KarthikeyanGatla/VibeGuard/docs/images/wiring_real_board.png

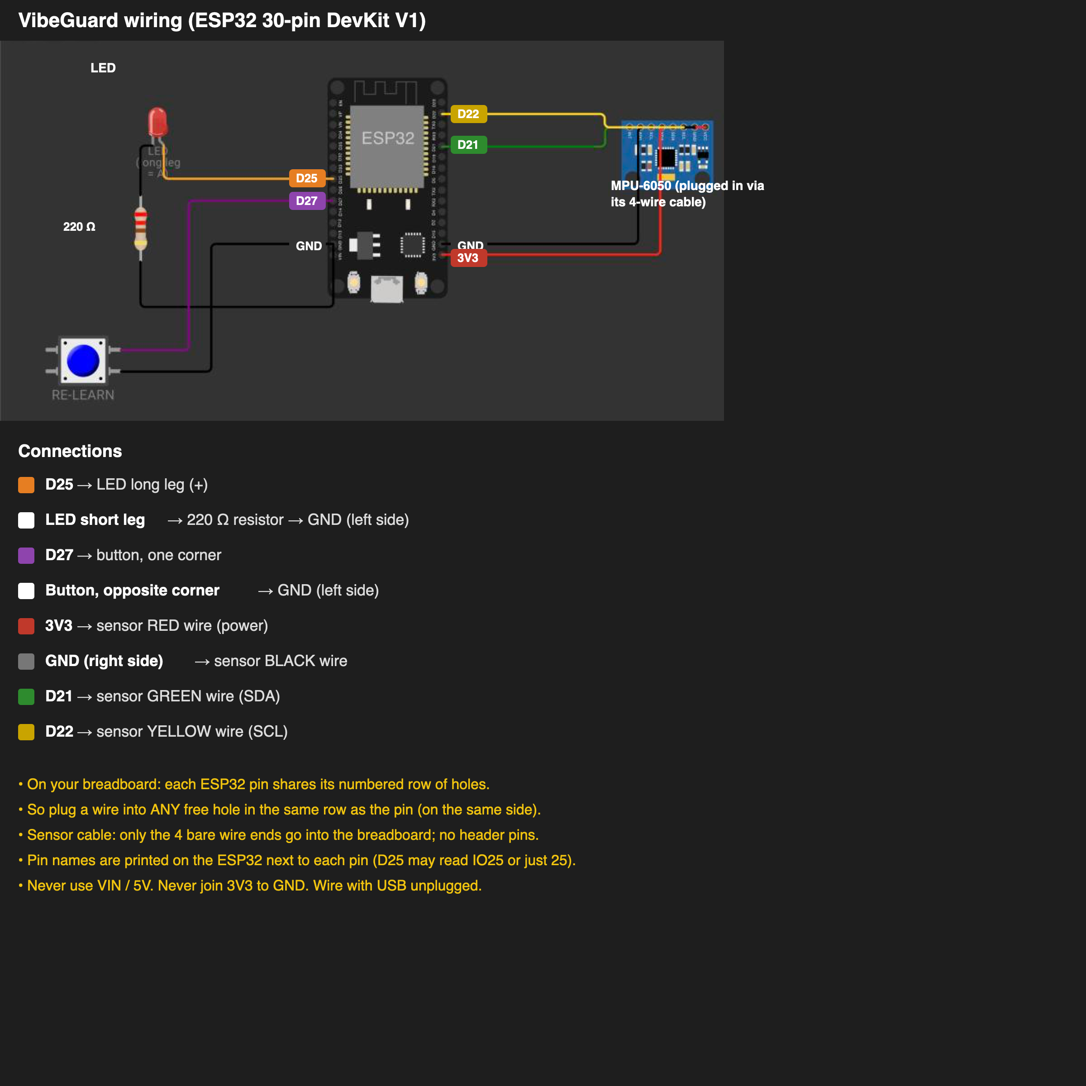
docs/images/wiring_real_board.png
