KarthikeyanGatla/VibeGuard/tests/results/summary.md

# VibeGuard host test results

Generated by tests/test_vibeguard.cpp. Do not edit by hand; re-run tests/run_tests.sh.

## 1. FFT and window

| Result | Test | Measurement |
|---|---|---|
| PASS | FFT matches direct DFT | max relative power error 1.54e-06 |
| PASS | Tone amplitude on bin centre | 50.00 mg in, 50.00 mg out |
| PASS | Half-bin tone (scalloping) | peak 42.44 mg = -1.42 dB loss; +-2-bin band holds 99.9 % of the energy |

Resolution: 1.953 Hz per bin, frame 0.512 s, Nyquist 250 Hz, 128 usable bins.

## 2. Shaft (1x) frequency estimate

Calibrate on a healthy motor at each speed, then compare the learned 1x with the true value.

| Result | Test | Measurement |
|---|---|---|
| PASS | 1x estimate 8.5-78 Hz (31 speeds) | mean |error| 0.028 Hz, max 0.289 Hz (bin = 1.95 Hz), 0 not found |

## 3. Fault classification (severity 1.0, 20 seeds each, 30 frames = 15.4 s after calibration)

Confusion matrix (rows = simulated condition, columns = VibeGuard's verdict):

| Simulated \ Verdict | NONE (healthy) | IMBALANCE | LOOSENESS | BEARING | MOTOR_OFF | Mean health % |
|---|---|---|---|---|---|---|
| healthy | 20 | 0 | 0 | 0 | 0 | 98.5 |
| imbalance | 0 | 20 | 0 | 0 | 0 | 20.8 |
| looseness | 0 | 0 | 20 | 0 | 0 | 0.0 |
| bearing | 0 | 0 | 0 | 20 | 0 | 32.8 |
| motor_off | 0 | 0 | 0 | 0 | 20 | 100.0 |

Detection latency (frames until the right fault is declared; 1 frame = 0.512 s):

| Fault | Mean | Worst |
|---|---|---|
| imbalance | 3.0 frames (1.5 s) | 3 frames (1.5 s) |
| looseness | 3.0 frames (1.5 s) | 3 frames (1.5 s) |
| bearing | 4.0 frames (2.0 s) | 4 frames (2.0 s) |

| Result | Test | Measurement |
|---|---|---|
| PASS | All 100 runs classified correctly | 100 / 100 correct |

## 4. False alarms on a healthy motor

| Result | Test | Measurement |
|---|---|---|
| PASS | Healthy, Same speed | 0 non-healthy frames in 4000 (34 min of running); lowest health 90.5 % |
| PASS | Healthy, Speed +5 % | 0 non-healthy frames in 4000 (34 min of running); lowest health 90.1 % |
| PASS | Healthy, Speed -5 % | 0 non-healthy frames in 4000 (34 min of running); lowest health 90.3 % |
| PASS | Healthy, Speed +9 % | 0 non-healthy frames in 4000 (34 min of running); lowest health 90.1 % |

## 5. Sensitivity: how small a fault is caught

Severity 0 = healthy, 1 = the nominal fault. Each point is the majority verdict over 5 seeds after 30 frames.

| Fault | First severity -> WARNING | First severity -> ALARM | Health at 0.25 / 0.5 / 1.0 / 1.5 |
|---|---|---|---|
| imbalance | 0.40 (1x amplitude x1.80) | 0.75 (1x amplitude x2.50) | 71 / 50 / 21 / 0 % |
| looseness | 0.20 (2x amplitude x1.80) | 0.35 (2x amplitude x2.40) | 47 / 17 / 0 / 0 % |
| bearing | 0.55 (resonance amplitude x5.40) | 0.95 (resonance amplitude x8.60) | 83 / 64 / 32 / 9 % |

## 6. Edge cases

| Result | Test | Measurement |
|---|---|---|
| PASS | Calibration skips motor-off frames | 10 stopped frames rejected, then 39 running frames = 19.97 s to learn |
| PASS | Motor stop and restart | stopped -> MOTOR_OFF, restarted -> HEALTHY (no false fault) |
| PASS | Recovery after repair | returns to HEALTHY 4 frames (2.0 s) after the fault is removed |
| PASS | No WARNING/ALARM flicker at the threshold | 0 state changes after the first ALARM in 10 runs of 100 frames (bearing, severity 1.0) |
| PASS | Aliasing above 250 Hz (documented limitation) | 270 Hz input appears at 230.5 Hz; MPU6050 DLPF (260 Hz) must remove it in hardware |
| PASS | MPU6050 resolution at +-4 g | 1 LSB = 0.122 mg; healthy 1x line = 40 mg = 327 LSB |

## 7. Processing time (host CPU, informational)

processFrame (mean removal, Hann, FFT, bands, decision): 1.2 us per frame on this Mac. The frame budget is 512000 us, so the ESP32 (about 50-100x slower than a desktop core for float work) still has a large margin. The real ESP32 figure is reported live as `rt.procUs` in /api/status.

Memory used by the engine object: 26736 bytes (most of it is the 39-frame calibration store).

---
**15 passed, 0 failed.**
