KarthikeyanGatla/VibeGuard/tests/results/severity_sweep.csv

scenario | severity | health | state | fault | ratio_imb | ratio_loose | ratio_bear
imbalance | 0.00 | 98.4 | HEALTHY | NONE | 1.011 | 0.962 | 1.045
imbalance | 0.05 | 92.8 | HEALTHY | NONE | 1.222 | 0.962 | 1.045
imbalance | 0.10 | 86.5 | HEALTHY | NONE | 1.452 | 0.962 | 1.044
imbalance | 0.15 | 80.8 | HEALTHY | NONE | 1.703 | 0.962 | 1.045
imbalance | 0.20 | 75.5 | HEALTHY | NONE | 1.974 | 0.962 | 1.045
imbalance | 0.25 | 70.5 | HEALTHY | NONE | 2.264 | 0.962 | 1.047
imbalance | 0.30 | 65.9 | HEALTHY | NONE | 2.575 | 0.962 | 1.044
imbalance | 0.35 | 61.5 | HEALTHY | NONE | 2.906 | 0.962 | 1.045
imbalance | 0.40 | 57.4 | WARNING | IMBALANCE | 3.256 | 0.962 | 1.044
imbalance | 0.45 | 53.5 | WARNING | IMBALANCE | 3.627 | 0.962 | 1.047
imbalance | 0.50 | 49.8 | WARNING | IMBALANCE | 4.018 | 0.963 | 1.048
imbalance | 0.55 | 46.3 | WARNING | IMBALANCE | 4.428 | 0.962 | 1.046
imbalance | 0.60 | 43.0 | WARNING | IMBALANCE | 4.859 | 0.962 | 1.044
imbalance | 0.65 | 39.8 | WARNING | IMBALANCE | 5.309 | 0.963 | 1.044
imbalance | 0.70 | 36.7 | WARNING | IMBALANCE | 5.779 | 0.962 | 1.045
imbalance | 0.75 | 33.8 | ALARM | IMBALANCE | 6.270 | 0.962 | 1.046
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
