KarthikeyanGatla/VibeGuard/tests/results/shaft_estimate.csv

true_hz | estimated_hz | error_hz | found
8.50 | 8.789 | 0.289 | 1
10.80 | 10.792 | -0.008 | 1
13.10 | 13.070 | -0.030 | 1
15.40 | 15.387 | -0.013 | 1
17.70 | 17.712 | 0.012 | 1
20.00 | 20.025 | 0.025 | 1
22.30 | 22.324 | 0.024 | 1
24.60 | 24.576 | -0.024 | 1
26.90 | 26.866 | -0.034 | 1
29.20 | 29.196 | -0.004 | 1
31.50 | 31.520 | 0.020 | 1
33.80 | 33.831 | 0.031 | 1
36.10 | 36.106 | 0.006 | 1
38.40 | 38.373 | -0.027 | 1
40.70 | 40.680 | -0.020 | 1
43.00 | 43.001 | 0.001 | 1
45.30 | 45.323 | 0.023 | 1
47.60 | 47.631 | 0.031 | 1
49.90 | 49.885 | -0.015 | 1
52.20 | 52.172 | -0.028 | 1
54.50 | 54.487 | -0.013 | 1
56.80 | 56.810 | 0.010 | 1
59.10 | 59.133 | 0.033 | 1
61.40 | 61.418 | 0.018 | 1
63.70 | 63.675 | -0.025 | 1
66.00 | 65.975 | -0.025 | 1
68.30 | 68.295 | -0.005 | 1
70.60 | 70.623 | 0.023 | 1
72.90 | 72.930 | 0.030 | 1
75.20 | 75.201 | 0.001 | 1
77.50 | 77.468 | -0.032 | 1
