KarthikeyanGatla/VibeGuard/(commit log)

2026-11-09 VibeGuard: ESP32 vibration fault diagnosis (firmware, docs, tests, prebuilt image)
    [severity_sweep.csv, shaft_estimate.csv]
2026-11-09 Add wiring diagram for the MPU-6050 with soldered header
2026-11-09 Wiring diagram: draw MPU-6050 header pins in the board's real order
